isaacjerish/bench/benchos/dashboard_ui/scene-imu.png

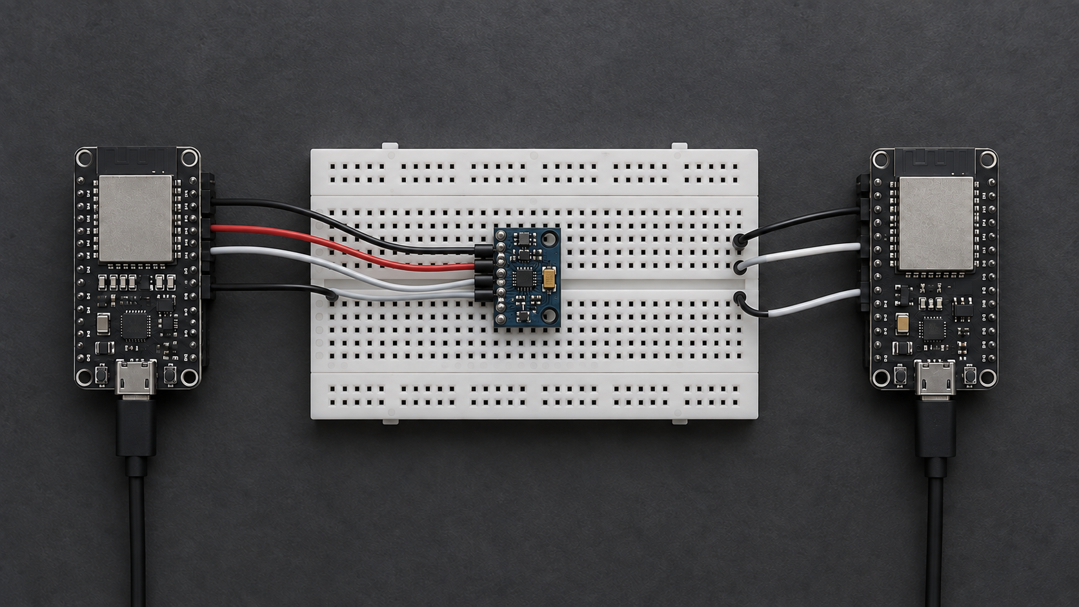
benchos/dashboard_ui/scene-imu.png
