isaacjerish/bench/benchos/dashboard_ui/scene-led.png

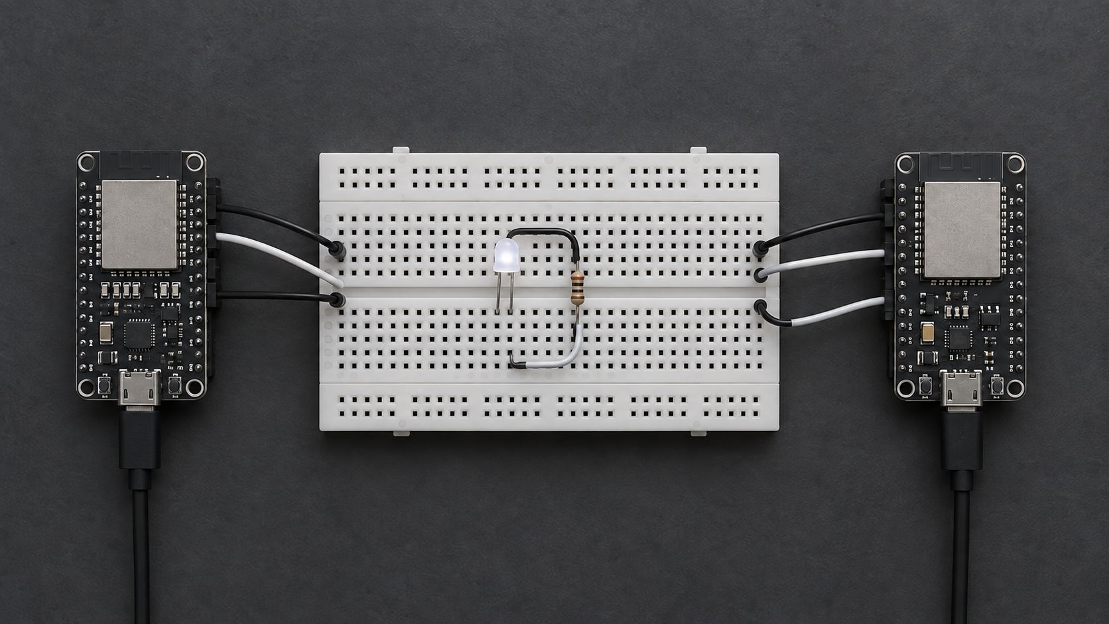
benchos/dashboard_ui/scene-led.png
