isaacjerish/bench/LIVE_DEMO_SCRIPT.md

# Benchy — current filming script

Use **[DEMO_4_PEOPLE.md](DEMO_4_PEOPLE.md)** for the updated four-person script,
spoken lines, UI clicks, model prompts, and exact physical repair sequence.

## Video structure

1. **LED + edited explosion hook.** “It's one LED. How hard could it be?”
   Explosion effect, then: “Maybe it's the code.”
2. **Who, what, why, scope.** ECE students and an ECE 4180 TA lose time tracing
   wiring and firmware problems. Benchy connects an AI debugging workflow to
   measurements on low-voltage breadboard projects.
3. **Describe the example and add photos.** A parcel monitor falsely reports
   water and blinks too quickly. Gemini Robotics ER provides visual context;
   the probes supply electrical evidence.
4. **Talk it through.** Use typed chat or Grok voice. Codex investigates the
   project and takes real measurements; show its actual diagnosis.
5. **Fix and upload.** Correct the two physical input wires, let Benchy prepare
   the timing repair, review it, and approve Build & flash in the website.
6. **Prove the result.** Remeasure, compare saved captures, and show the LED
   responding correctly. Close on the time saved for students and TAs.

Target **3–4 minutes edited**. Preserve real AI results and label sped-up build
waits. The former panel-by-panel technical pitch is superseded by this story.
Detailed GPIO/measurement instructions belong in the crew notes, not narration.

The last verified setup already contains both faults. Keep it for the opening;
follow the current script's preflight to confirm fresh evidence before filming.
