isaacjerish/bench/(commit log)

2026-09-26 Build BenchOS hardware debugging MVP
    [servo_signal.yaml]
2026-09-26 Add light sensor physical cross-check demo
2026-09-26 Record live light sensor fault and repair validation
2026-09-26 Clarify servo supply limit and current wiring
2026-09-26 Redesign dashboard as monochrome hardware workbench
    [dashboard.py, test_dashboard.py]
2026-09-26 Document live BenchOS status and next wiring
2026-09-26 Validate MPU wiring and flag saturated accelerometer axis
2026-09-26 Add second probe and IMU power fault isolation
2026-09-26 Prepare gated read-only I2C activity monitor
2026-09-26 Show live bus evidence and identify boards by USB identity
2026-09-26 Explain Benchy workflow and probe map in demo video
2026-09-26 Slow down demo and enlarge circuit explanation
2026-09-26 Add three-sensor Plant Sentinel and generic telemetry cross-checks
2026-09-26 Expose generic probe telemetry checks to agents and CLI
2026-09-26 Clarify fresh DUT errors and polish telemetry cards
    [harness.py]
2026-09-26 Add live evidence aging, probe coverage, and saved capture comparison
2026-09-26 Persist instrument captures with wiring, source, and timing context
2026-09-26 Explain demo wiring in component order
2026-09-26 Validate rebuilt light and LED paths with physical captures
2026-09-26 Record passing water-only alarm and completed wiring checks
2026-09-26 Add concise physical wiring fault guide for demo filming
2026-09-26 Record merged dashboard verification and current hardware status
2026-09-27 Record color probe stimulus checks and UI comparison
2026-09-27 Validate wiring and firmware demo failures through live UI
    [current.yaml]
2026-09-27 Prepare and document combined wiring and timing fault exercise
2026-09-27 Add phone visual inspection with probe-verified findings
    Gemini returns hypotheses from a phone photo; only an allowlisted probe
    measurement is recorded as an electrical fact. Reads the key from a
    gitignored .env, and refuses to advertise a QR address that is not
    reachable from the phone.
2026-09-27 Add live demo pitch and annotate the seeded software fault
2026-09-27 Fix dashboard agent integration on macOS and verify live demo
    [dashboard.py, test_dashboard_agent.py, test_visual_inspection.py, test_voice_debug.py, visual_inspection.py]
2026-09-27 Polish website voice flow and add four-person demo rehearsal
2026-09-27 Surface Codex stream failures in dashboard chat and voice
    [dashboard.py, test_dashboard_agent.py]
